ryanmccormickdev/bare-metal-audio/hardware/renders/aug14_cnc_copper_bottom.png

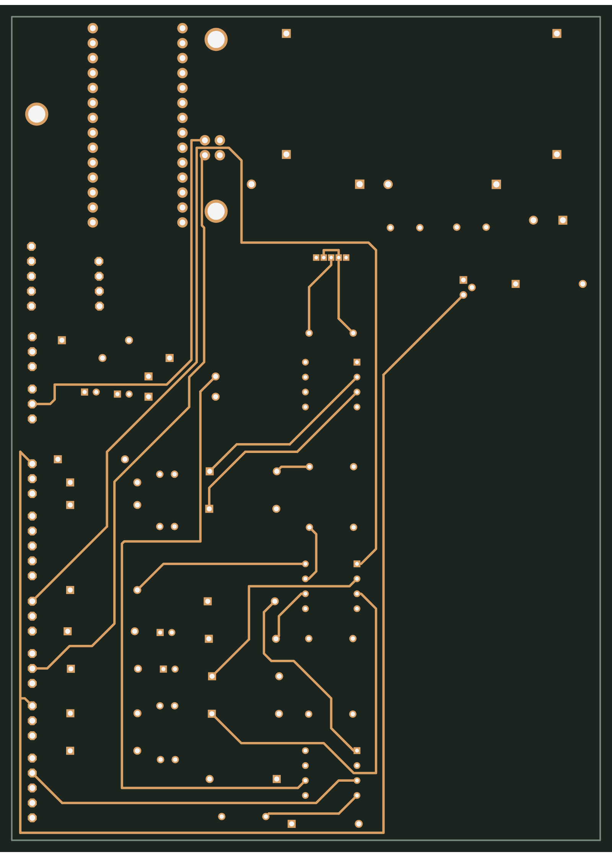
hardware/renders/aug14_cnc_copper_bottom.png
