ryanmccormickdev/bare-metal-audio/enclosure/printed-parts/audiointerfacesketching.3mf

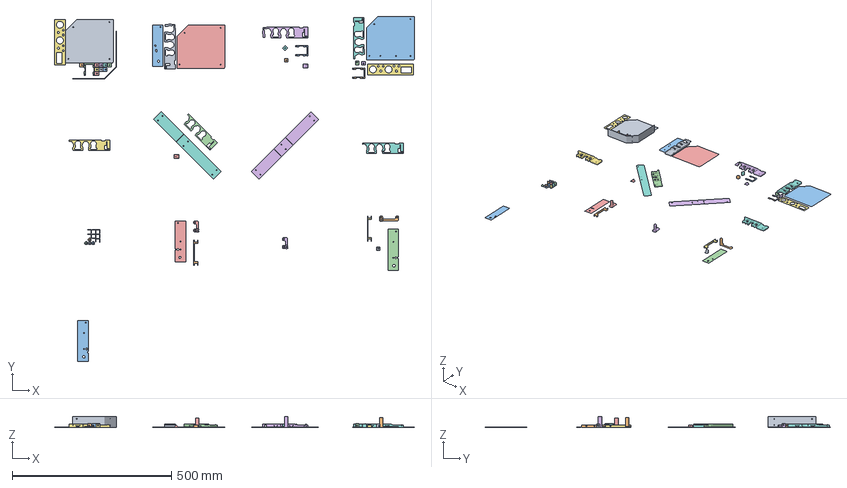
[picture p28: CAD file, 2026-11-01]
enclosure/printed-parts/audiointerfacesketching.3mf
1130.4 x 1084.0 x 34.0 mm
backedgemetal.stl
headphoneholder.stl x 3
body4.stl x 3
Stencil.stl
wireholder.stl x 2
edgeunbent.stl
cornerconnector.stl
bottom.stl
new_cutout.stl x 2
newcornerbracket.stl
cutout1.stl x 3
frontmetal.stl
one.stl
bottommetal.stl
two.stl
cutout2.stl x 2
bracket2.stl x 4
topmetal.stl
edgeconnector2.stl
metalcutoutfront.stl
edgeconnector.stl
edgeconnector3.stl
metalcutoutside.stl
bracket.stl x 15
feet.stl x 4
