ryanmccormickdev/bare-metal-audio/enclosure/top-plate/top-plate_rotated-180.dxf

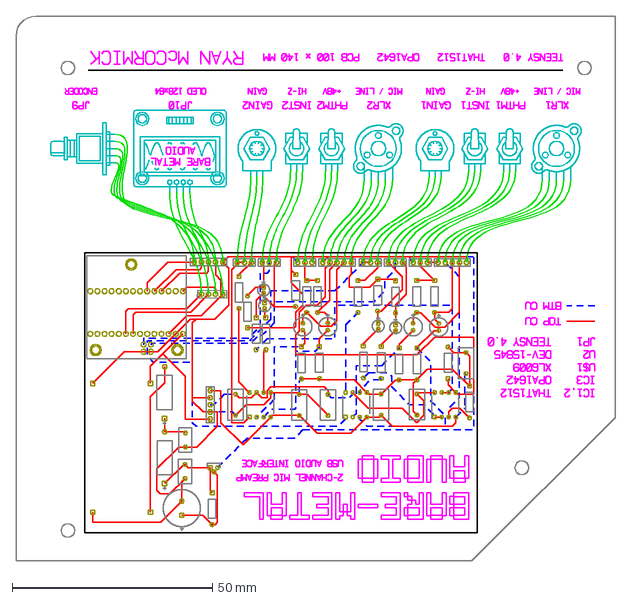
[picture p29: CAD file, 2026-11-01]
enclosure/top-plate/top-plate_rotated-180.dxf
149.6 x 136.1 mm
