ryanmccormickdev/bare-metal-audio/enclosure/top-plate/top-plate.dxf

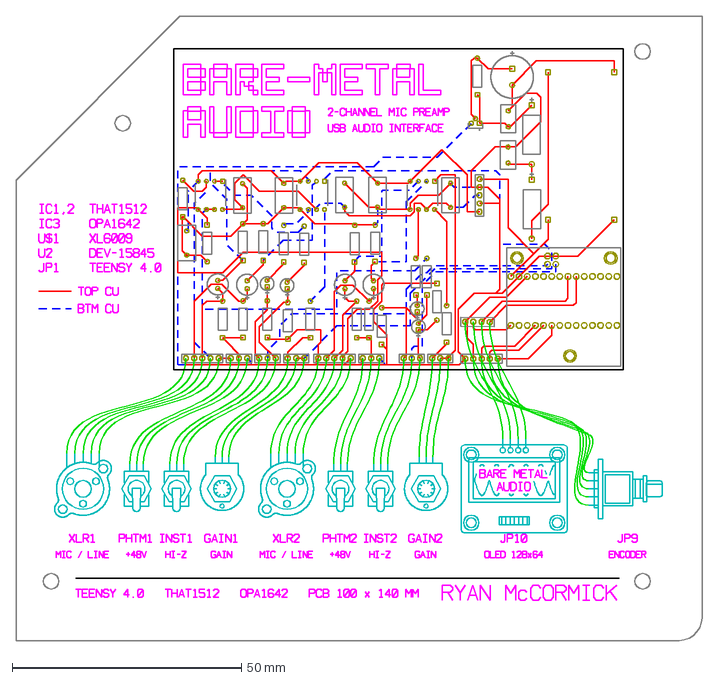
[picture p30: CAD file, 2026-11-01]
enclosure/top-plate/top-plate.dxf
149.6 x 136.1 mm
