ryanmccormickdev/bare-metal-audio/media/2026-07-15-0005-mic-test.jpg

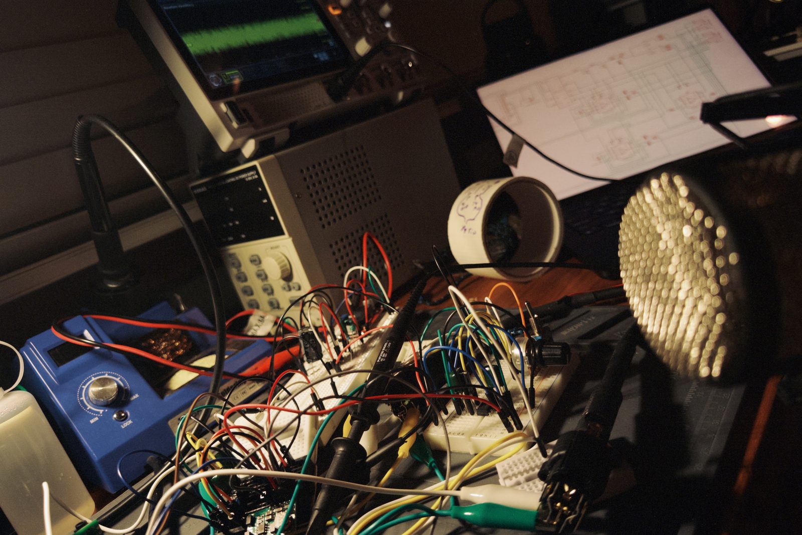
media/2026-07-15-0005-mic-test.jpg
