ryanmccormickdev/bare-metal-audio/hardware/design/bare-metal-audio_2026-09-07.sch

## EAGLE design hardware/design/bare-metal-audio_2026-09-07.sch (2026-11-01)

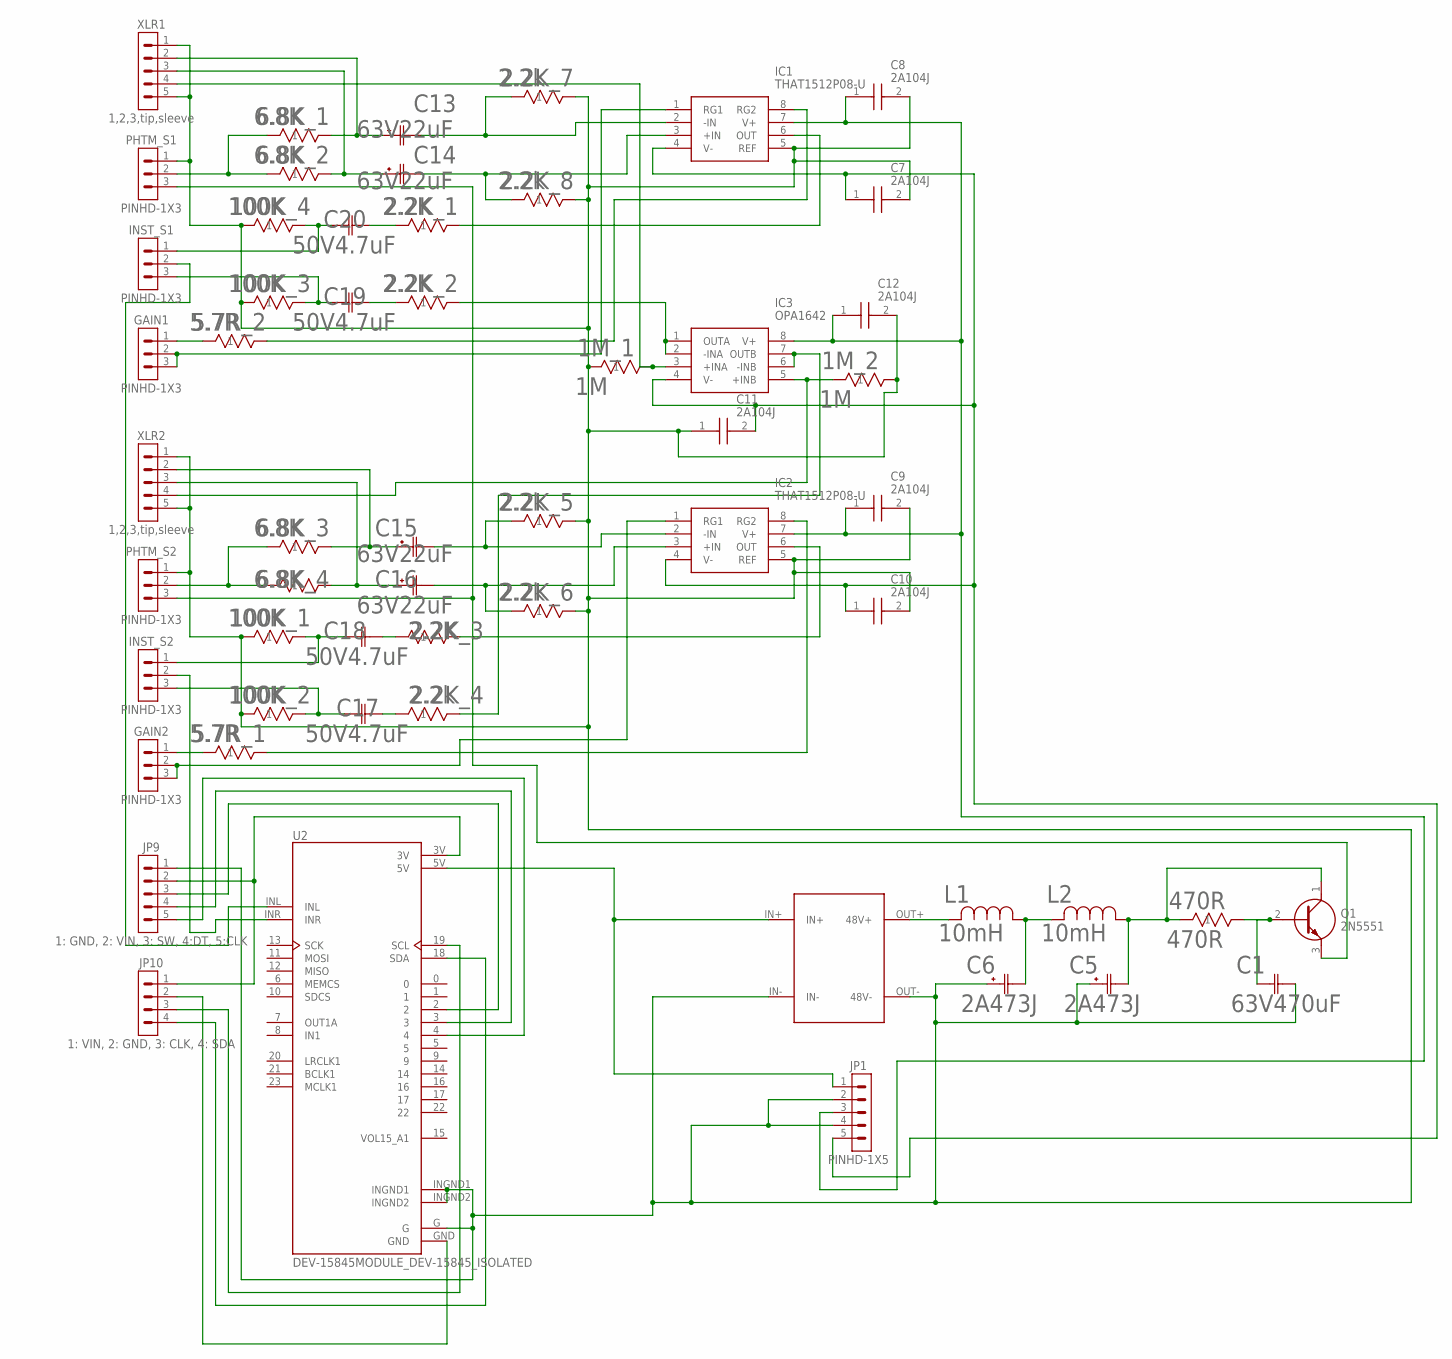
[picture p32: schematic bare-metal-audio_2026-09-07.sch]

Parts:
1M_1, 1M_2: 1M; RES_TYCO_YR1_TYC
2.2K_1, 2.2K_2, 2.2K_3: 2.2K; RES_TYCO_YR1_TYC
2.2K_4, 2.2K_5, 2.2K_6, 2.2K_7, 2.2K_8: 2.2k; RES_TYCO_YR1_TYC
5.7R_1, 5.7R_2: 5.7R; RES_TYCO_YR1_TYC
6.8K_1, 6.8K_2, 6.8K_3, 6.8K_4: 6.8K; RES_TYCO_YR1_TYC
100K_1, 100K_2, 100K_3, 100K_4: 100K; RES_TYCO_YR1_TYC
470R: 470R; RES_TYCO_YR1_TYC
C1: 63V470uF; CAP_EEUFC_125X25_PAN
C5, C6: 2A473J; CAP_QYX_4P5X8P5X14_NCH
C7, C8, C9, C10, C11, C12: 2A104J; QYX2A104JTP
C13, C14, C15, C16: 63V22uF; CAP_UEP_6P3X11_NCH
C17, C18, C19, C20: 50V4.7uF; CAP_4_X_7_PAN
GAIN1, GAIN2: PINHD-1X3; 1X03
IC1, IC2: THAT1512P08-U; DIP876W46P254L952H432Q8N
IC3: OPA1642; DIP876W46P254L952H432Q8N
INST_S1, INST_S2: PINHD-1X3; 1X03
JP1: PINHD-1X5; 1X05
JP9: 1: GND, 2: VIN, 3: SW, 4:DT, 5:CLK; 1X05
JP10: 1: VIN, 2: GND, 3: CLK, 4: SDA; 1X04
L1, L2: 10mH; IND_B82144A_12X5P2_TDK
PHTM_S1, PHTM_S2: PINHD-1X3; 1X03
Q1: 2N5551
U2: DEV-15845MODULE_DEV-15845_ISOLATED; MODULE_DEV-15845_ISOLATED
U$1: XL6009_BOOST; XL6009_FOOT
XLR1, XLR2: 1,2,3,tip,sleeve; 1X05

Connections:
5V: JP1.1, U2.5V, U$1.IN+
+12V: C8.1, C9.1, C12.1, IC1.7 (V+), IC2.7 (V+), IC3.8 (V+), JP1.3
-12V: C7.1, C10.1, C11.2, IC1.4 (V-), IC2.4 (V-), IC3.4 (V-), JP1.5
GND: 1M_1.1, 1M_2.2, 2.2K_5.2, 2.2K_6.2, 2.2K_7.2, 2.2K_8.2, 100K_1.1, 100K_2.1, 100K_3.1, 100K_4.1, C1.2, C5.1, C6.1, C7.2, C8.2, C9.2, C10.2, C11.1, C12.2, IC1.5 (REF), IC2.5 (REF), JP1.2, JP1.4, JP9.1, PHTM_S1.1, PHTM_S2.1, U2.G, U2.INGND1, U2.INGND2, U$1.IN-, U$1.OUT- (48V-), XLR1.1, XLR1.5, XLR2.1, XLR2.5
unnamed: 6.8K_1.2, C13.1, XLR1.2
unnamed: JP10.4, U2.18 (SDA)
unnamed: JP9.3, U2.2
unnamed: JP9.4, U2.3
unnamed: JP9.5, U2.4
unnamed: L1.2, U$1.OUT+ (48V+)
unnamed: C6.2, L1.1, L2.2
unnamed: 470R.1, C5.2, L2.1, Q1.1 (C)
unnamed: 470R.2, C1.1, Q1.2 (B)
unnamed: PHTM_S1.3, PHTM_S2.3, Q1.3 (E)
unnamed: 6.8K_1.1, 6.8K_2.1, PHTM_S1.2
unnamed: 6.8K_3.1, 6.8K_4.1, PHTM_S2.2
unnamed: 6.8K_3.2, C15.1, XLR2.2
unnamed: 6.8K_4.2, C16.1, XLR2.3
unnamed: 2.2K_6.1, C16.2, IC2.3 (+IN)
unnamed: 2.2K_5.1, C15.2, IC2.2 (-IN)
unnamed: GAIN1.2, GAIN1.3, IC1.1 (RG1)
unnamed: 6.8K_2.2, C14.1, XLR1.3
unnamed: 2.2K_7.1, C13.2, IC1.2 (-IN)
unnamed: 2.2K_8.1, C14.2, IC1.3 (+IN)
unnamed: 100K_1.2, C18.1, INST_S2.1
unnamed: 5.7R_2.1, GAIN1.1
unnamed: 5.7R_1.1, GAIN2.1
unnamed: GAIN2.2, GAIN2.3, IC2.1 (RG1)
unnamed: 5.7R_1.2, IC2.8 (RG2)
unnamed: 5.7R_2.2, IC1.8 (RG2)
unnamed: 2.2K_1.2, IC1.6 (OUT)
unnamed: 2.2K_1.1, C20.2
unnamed: 100K_4.2, C20.1, INST_S1.1
unnamed: 100K_3.2, C19.1, INST_S1.3
unnamed: 2.2K_2.1, C19.2
unnamed: 2.2K_4.2, IC3.6 (-INB), IC3.7 (OUTB)
unnamed: 100K_2.2, C17.1, INST_S2.3
unnamed: 2.2K_4.1, C17.2
unnamed: 2.2K_3.1, C18.2
unnamed: 2.2K_3.2, IC2.6 (OUT)
unnamed: 2.2K_2.2, IC3.1 (OUTA), IC3.2 (-INA)
unnamed: 1M_1.2, IC3.3 (+INA), XLR1.4
unnamed: 1M_2.1, IC3.5 (+INB), XLR2.4
unnamed: INST_S2.2, U2.INR
unnamed: INST_S1.2, U2.INL
unnamed: JP10.2, U2.GND
unnamed: JP10.3, U2.19 (SCL)
VOL_3.3V: JP9.2, JP10.1, U2.3V
