ryanmccormickdev/bare-metal-audio/hardware/design/history/2026-07-14_v1_schematic.sch

## EAGLE design hardware/design/history/2026-07-14_v1_schematic.sch (2026-11-01)

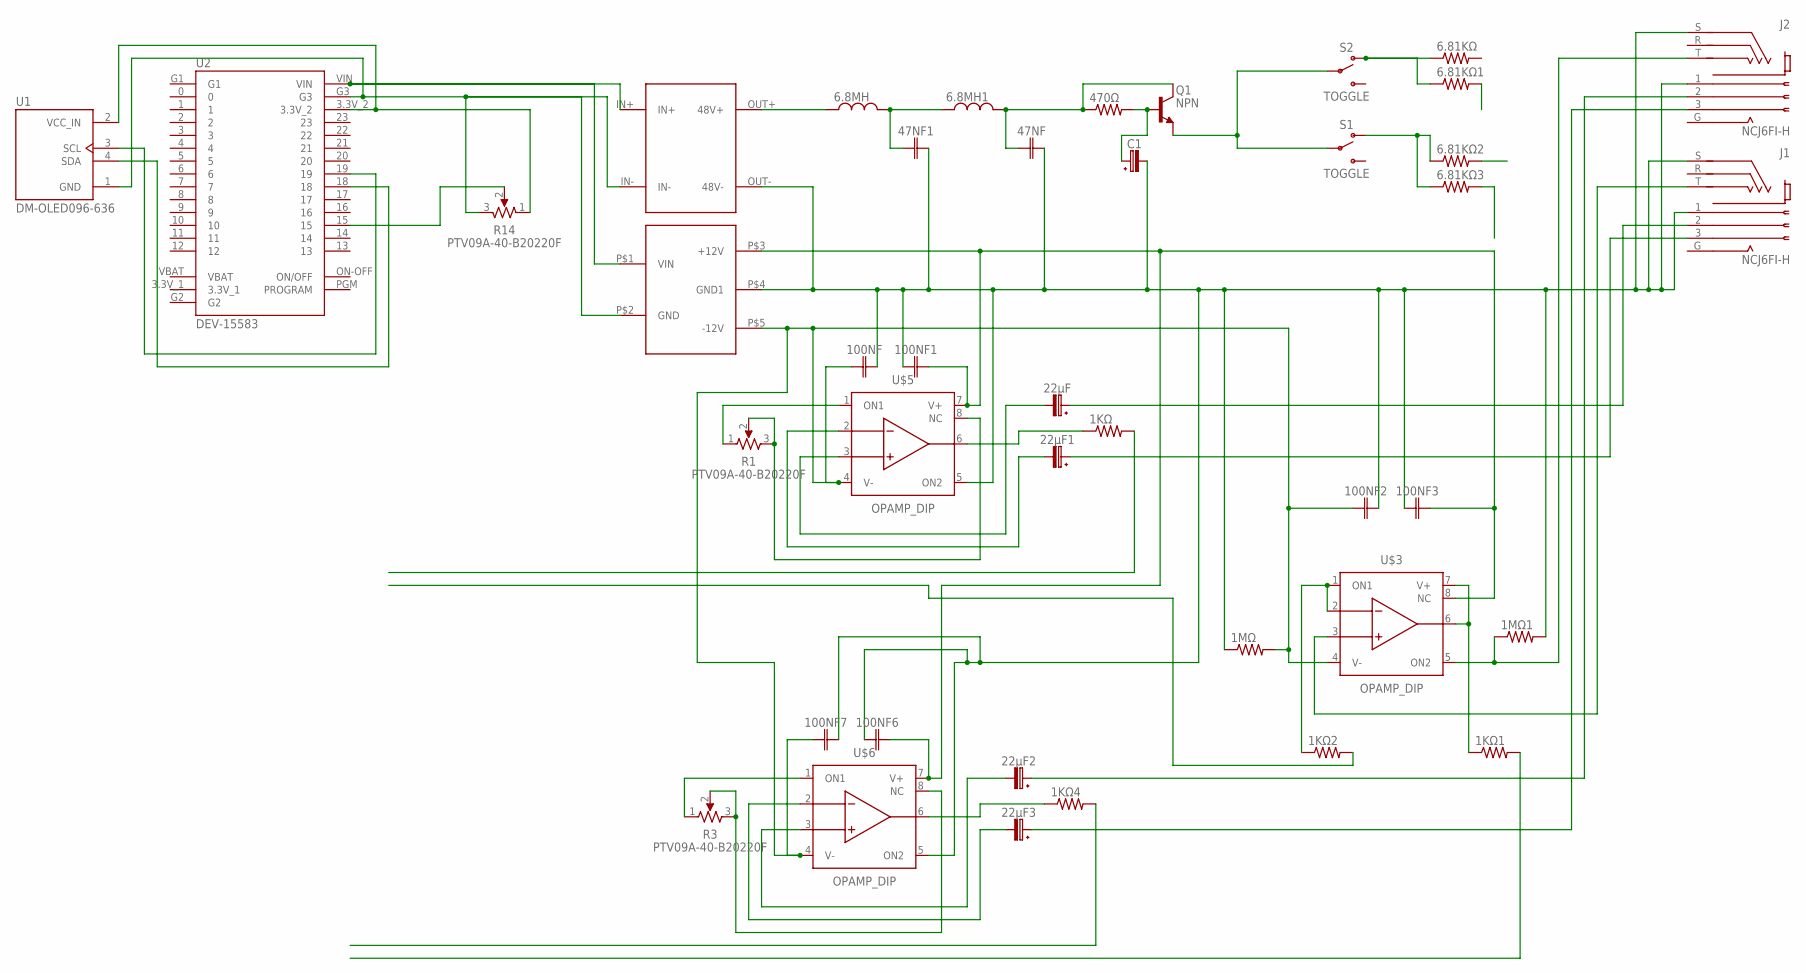
[picture p33: schematic 2026-07-14_v1_schematic.sch]

Parts:
1KΩ, 1KΩ1, 1KΩ2, 1KΩ4, 1MΩ, 1MΩ1, 6.81KΩ, 6.81KΩ1, 6.81KΩ2, 6.81KΩ3, 470Ω: R-US_CHIP-0402(1005-METRIC); RESC1005X40
6.8MH, 6.8MH1: INDUCTOR_CHIP-0402(1006-METRIC); INDC1006X60N
22µF, 22µF1, 22µF2, 22µF3: C-POL_TANTALUM-1206(3216-METRIC); CAPMP3216X180N
47NF, 47NF1, 100NF, 100NF1, 100NF2, 100NF3, 100NF6, 100NF7: C_CHIP-0402(1005-METRIC); CAPC1005X60
C1: C-POL_TANTALUM-1206(3216-METRIC); CAPMP3216X180N
J1, J2: NCJ6FI-H; NEUTRIK_NCJ6FI-H
Q1: NPN; TO92
R1, R3, R14: PTV09A-40-B20220F; PTV09A-X
S1, S2: TOGGLE; SWITCH-SPDT-PTH-8.5X3.7MM
U1: DM-OLED096-636; MODULE_DM-OLED096-636
U2: DEV-15583; MODULE_DEV-15583
U$1: XL6009_BOOST; XL6009_FOOT
U$2: DD1718PA_BOOST; DD1718PA_FOOT
U$3, U$5, U$6: OPAMP_DIP; DIP826W53P254L959H508Q8B

Connections:
unnamed: U2.VIN, U$1.IN+, U$2.P$1 (VIN)
unnamed: R14.3, U1.1 (GND), U2.G3, U$1.IN-, U$2.P$2 (GND)
unnamed: 1MΩ.1, 1MΩ1.2, 47NF.2, 47NF1.2, 100NF.2, 100NF1.1, 100NF2.2, 100NF3.1, 100NF6.1, 100NF7.2, C1.2 (-), J1.1, J1.S, J2.1, J2.S, U$1.OUT- (48V-), U$2.P$4 (GND1), U$5.5 (ON2), U$6.5 (ON2)
unnamed: 1MΩ.2, 100NF.1, 100NF2.1, 100NF7.1, U$2.P$5 (-12V), U$3.4 (V-), U$5.4 (V-), U$6.4 (V-)
unnamed: J1.T, U$3.3 (+IN)
unnamed: 6.8MH.2, 6.8MH1.1, 47NF1.1
unnamed: 6.8MH1.2, 47NF.1, 470Ω.1, Q1.1 (C)
unnamed: 6.8MH.1, U$1.OUT+ (48V+)
unnamed: 470Ω.2, C1.1 (+), Q1.2 (B)
unnamed: Q1.3 (E), S1.2, S2.2
unnamed: 6.81KΩ.1, 6.81KΩ1.1, S2.1 (O)
unnamed: 6.81KΩ2.1, 6.81KΩ3.1, S1.1 (O)
unnamed: 100NF1.2, 100NF3.2, 100NF6.2, U$2.P$3 (+12V), U$3.8 (NC), U$5.7 (V+), U$6.7 (V+)
unnamed: 1MΩ1.1, J2.T, U$3.5 (ON2)
unnamed: 22µF.1 (+), J1.2
unnamed: 22µF1.1 (+), J1.3
unnamed: R14.2, U2.15
unnamed: R14.1, U1.2 (VCC_IN), U2.3.3V_2
unnamed: U1.3 (SCL), U2.19
unnamed: U1.4 (SDA), U2.18
unnamed: 22µF.2 (-), U$5.3 (+IN)
unnamed: 22µF1.2 (-), U$5.2 (-IN)
unnamed: R1.1, U$5.1 (ON1)
unnamed: R1.2, R1.3, U$5.8 (NC)
unnamed: 1KΩ.1, U$5.6 (OUT)
unnamed: 1KΩ2.1, U$3.1 (ON1), U$3.2 (-IN)
unnamed: 1KΩ1.1, U$3.6 (OUT), U$3.7 (V+)
unnamed: 22µF2.1 (+), J2.2
unnamed: 22µF3.1 (+), J2.3
unnamed: 22µF2.2 (-), U$6.3 (+IN)
unnamed: 22µF3.2 (-), U$6.2 (-IN)
unnamed: R3.1, U$6.1 (ON1)
unnamed: R3.2, R3.3, U$6.8 (NC)
unnamed: 1KΩ4.1, U$6.6 (OUT)
