ryanmccormickdev/bare-metal-audio/(notices)

Notices in the files:
parts and their libraries:
COPYRIGHT: Copyright (C) 2026 Ultra Librarian. All rights reserved.
